isramos/dtmf-shield/docs/dtmf_mod3_schematic.pdf

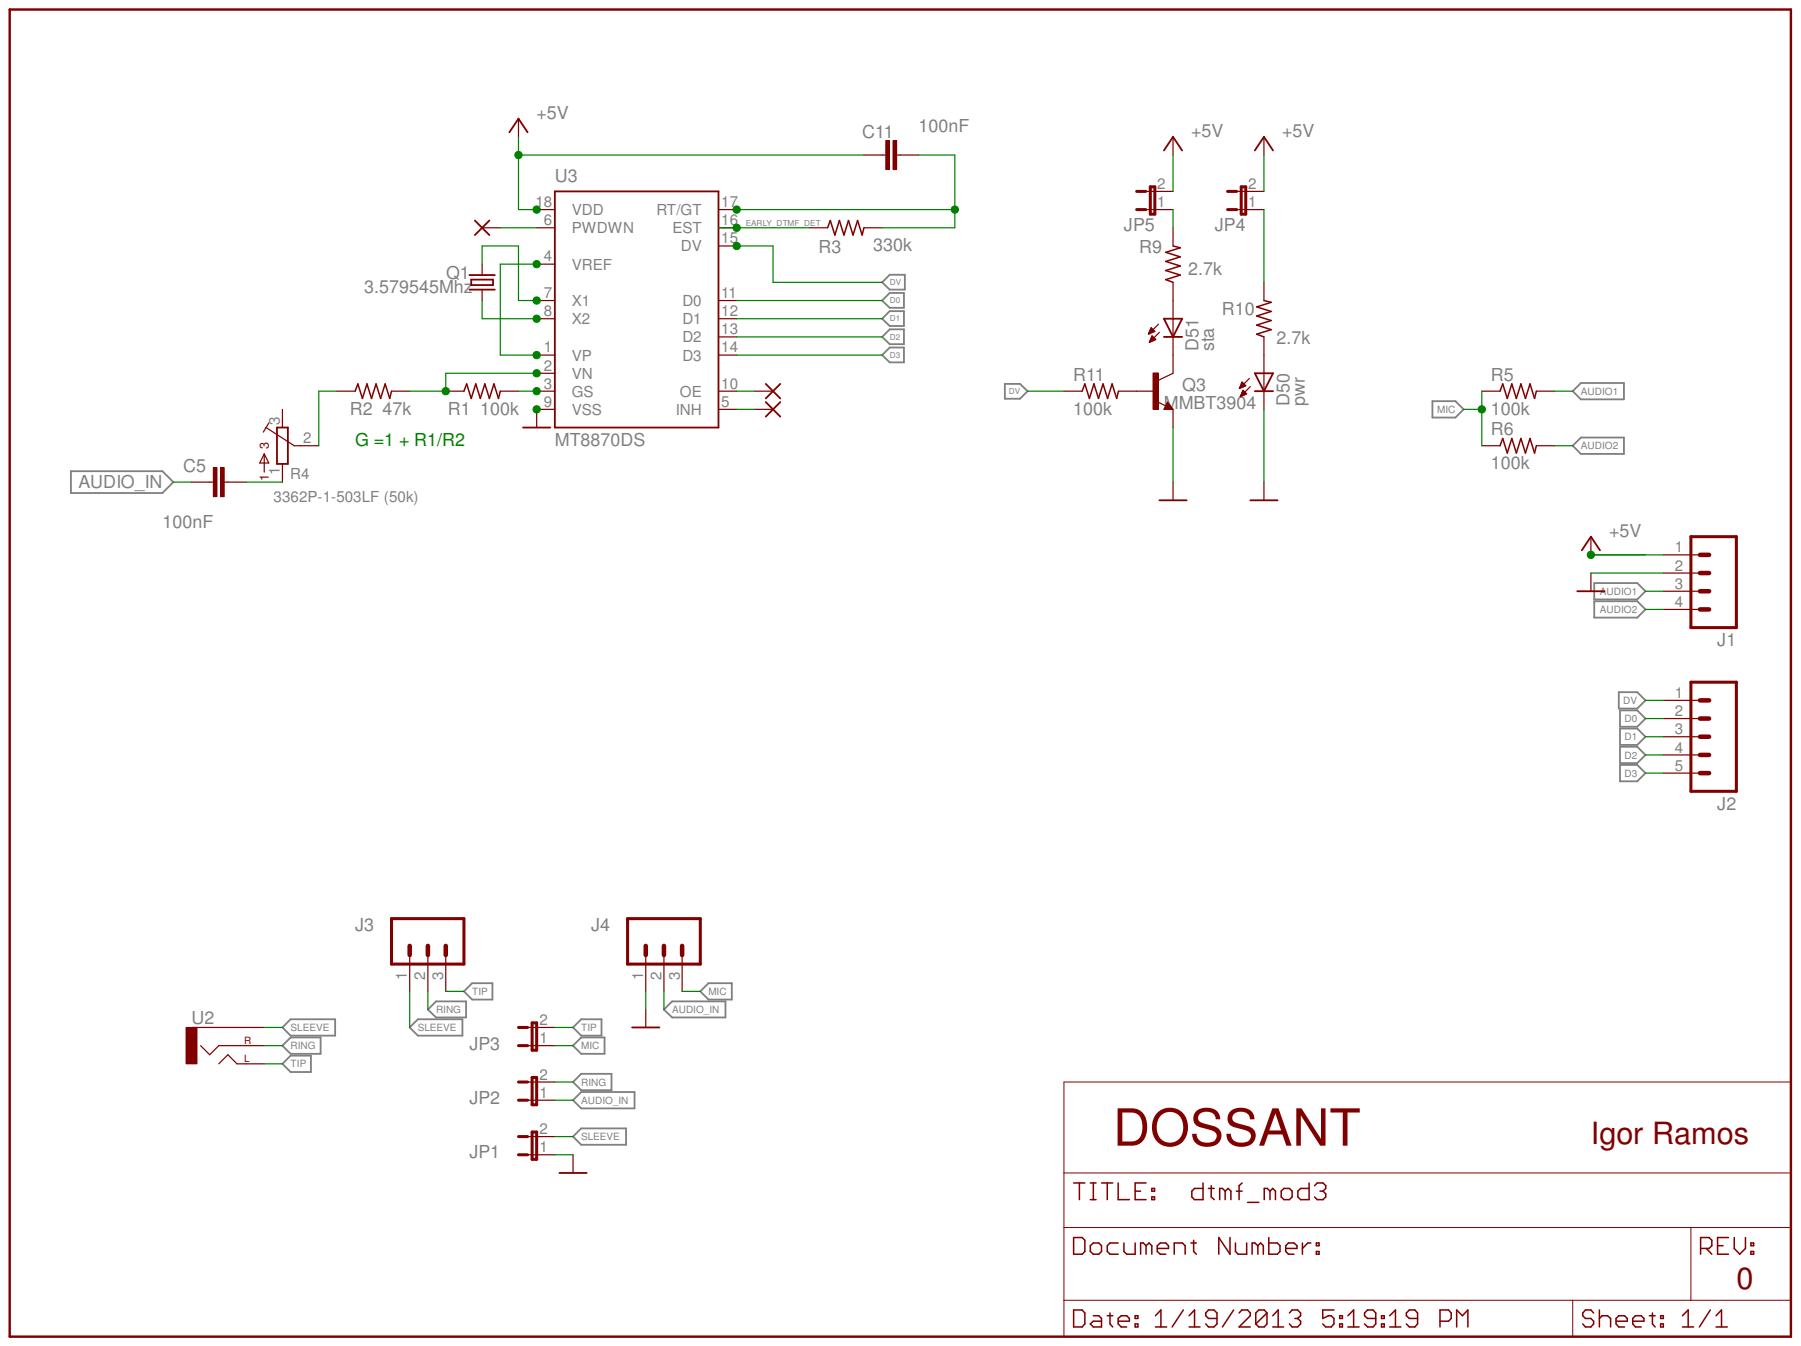
[picture p2: page 1]
